shubhammishra0212/nazar-hardware/diagrams/NAZAR-Circuit-Diagrams-Cirkit.pdf

# NAZAR v5 - Circuit Diagrams

ESP32 DevKit (38-pin) - 24 V adapter, two LM2596 bucks (belt motor on 5.5 V, LEDs on 12 V), belt relay - 2 Nov 2026

NAZAR v5 - Team Parakh - INDUX 5.0 | 1 / 7

### Power

From | To | Notes
24 V adapter + | LM2596 #1 IN+ and LM2596 #2 IN+ | adapter 2 A or more
24 V adapter - | LM2596 #1 IN- and LM2596 #2 IN- | common ground
LM2596 #1 OUT+ | ESP32 5V, MG996R red, C1 +, relay DC+, S1 | set to 5.5 V
S1 COM | INA219 VIN+ | belt ON / OFF switch
INA219 VIN- | Relay NO | INA219 measures motor current
Relay COM | Belt motor + | belt runs only while the relay is on
LM2596 #1 OUT- | ESP32 GND, MG996R brown, C1, relay DC-, motor -
LM2596 #2 OUT+ | LED strip +12V | set to 12 V, LEDs only
LM2596 #2 OUT- | LED strip GND

### ESP32 pin map

ESP32 pin | Goes to | Notes
GPIO21 (SDA) | INA219, MPU-6050, BH1750 SDA | blue
GPIO22 (SCL) | INA219, MPU-6050, BH1750 SCL | green
3.3 V | I2C modules, FC-51, DS18B20, 4.7 kΩ | red
GPIO18 | FC-51 OUT | purple
GPIO4 | DS18B20 DQ + 4.7 kΩ to 3.3 V | yellow
GPIO13 | 330 Ω -> MG996R signal | cyan
GPIO26 | Relay IN (HIGH = belt runs, LOW = stops) | indigo
5V | LM2596 #1 OUT+ (5.5 V) | orange
GND | all grounds joined | black

### Before you power it

### 1. Connect only the 24 V adapter. Turn each buck's brass screw and read the

output with a multimeter: LM2596 #1 = 5.5 V, LM2596 #2 = 12 V.

### 2. Mark the bucks "5V" and "12V" with tape. 12 V on the ESP32 side

destroys the ESP32 and the servo.

3. Fit C1 (1000 µF 16 V) across the 5.5 V rail: + to 5.5 V, stripe to GND.

### 4. Use thick wire (about 20 AWG) for both power rails. LM2596 #1 now feeds

the ESP32, servo, relay AND belt motor - stick a heatsink on it.
The belt runs at about half speed on 5.5 V (that is expected).

### 5. If the ESP32 resets when the servo moves, add another 470-1000 µF

capacitor right at the ESP32 5V and GND pins.

### 6. Check the ESP32 has its USB diode before plugging USB in while the

5.5 V rail is live, or unplug the 5V wire while uploading code.

### 7. Relay: our BC547 board is active HIGH (GPIO26 HIGH = belt runs). The belt

only runs while the ESP32 is on and holds the relay; it stops under the camera for each washer. A 1N4007 across the motor (stripe to +) is a plus.

### I2C addresses

I2C device | Address | Strap
INA219 | 0x40 | default
MPU-6050 | 0x68 | AD0 -> GND
BH1750 | 0x23 | ADDR -> GND

# Complete wiring

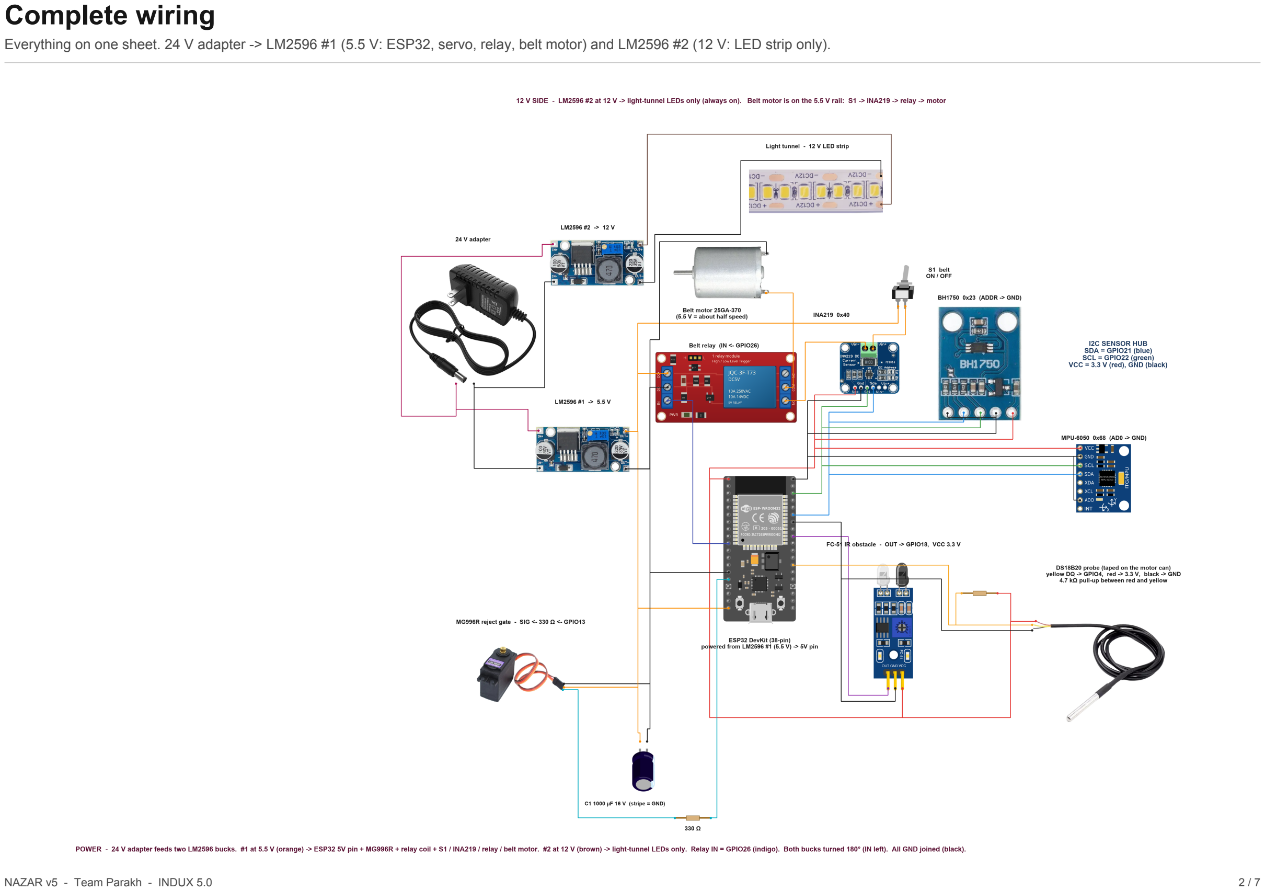
[picture p4: page 2]

Everything on one sheet. 24 V adapter -> LM2596 #1 (5.5 V: ESP32, servo, relay, belt motor) and LM2596 #2 (12 V: LED strip only).

# Part 1 - Power, light tunnel, belt motor and relay

LM2596 #1 (5.5 V): ESP32 5V pin, MG996R, C1, relay coil, and S1 -> INA219 -> relay -> belt motor. LM2596 #2 (12 V): LED strip only (always on). Relay IN = GPIO26.

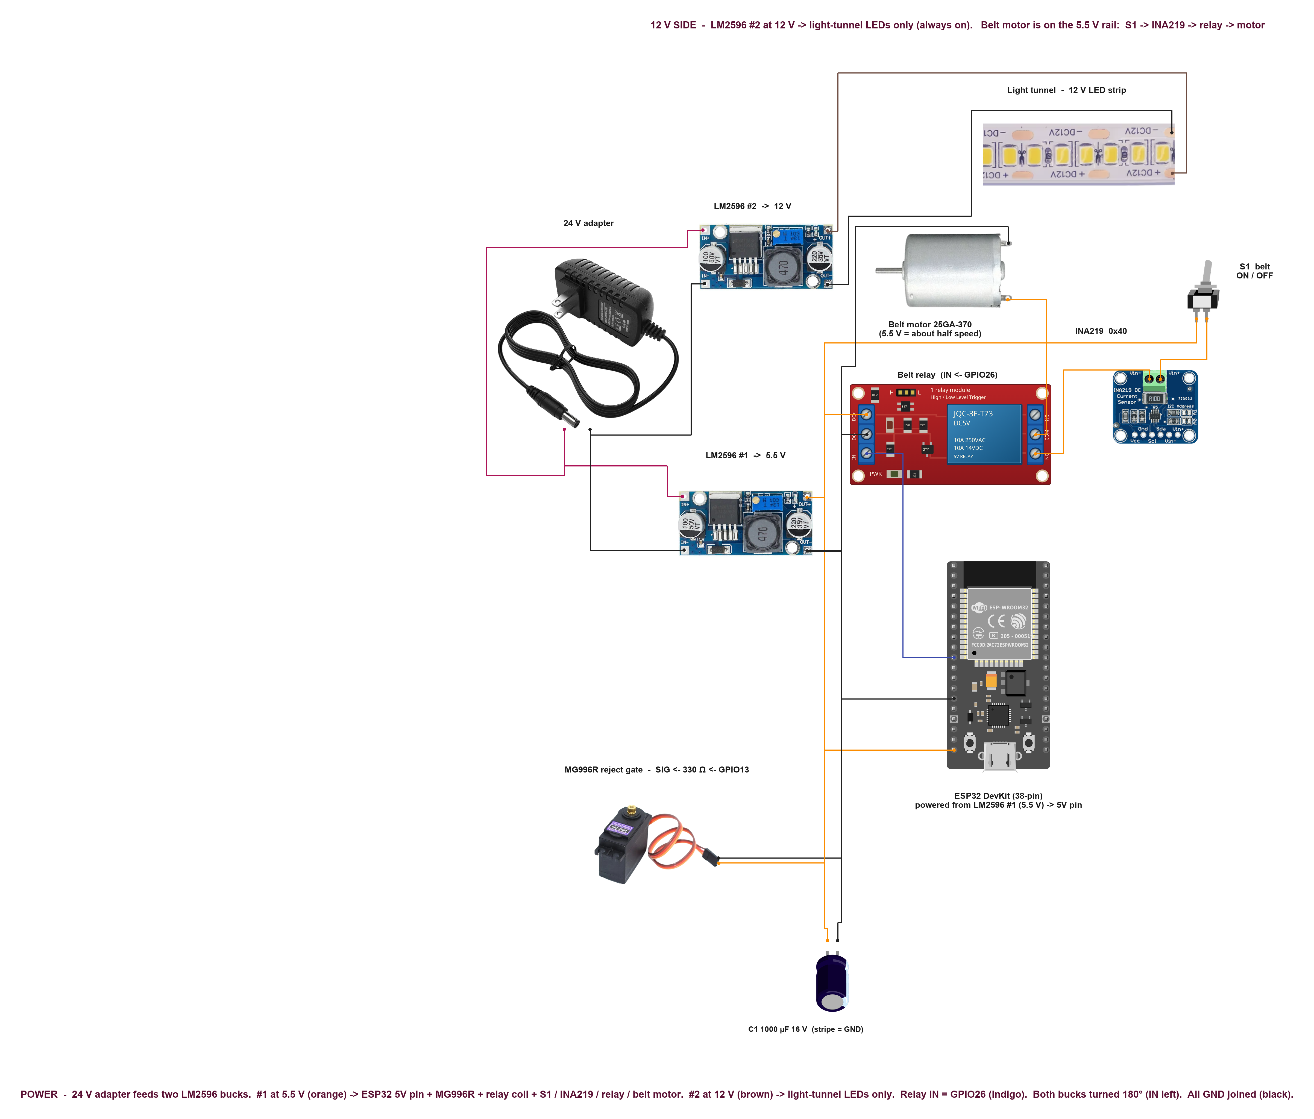
[picture p5: figure]

# Part 2 - I2C sensor hub

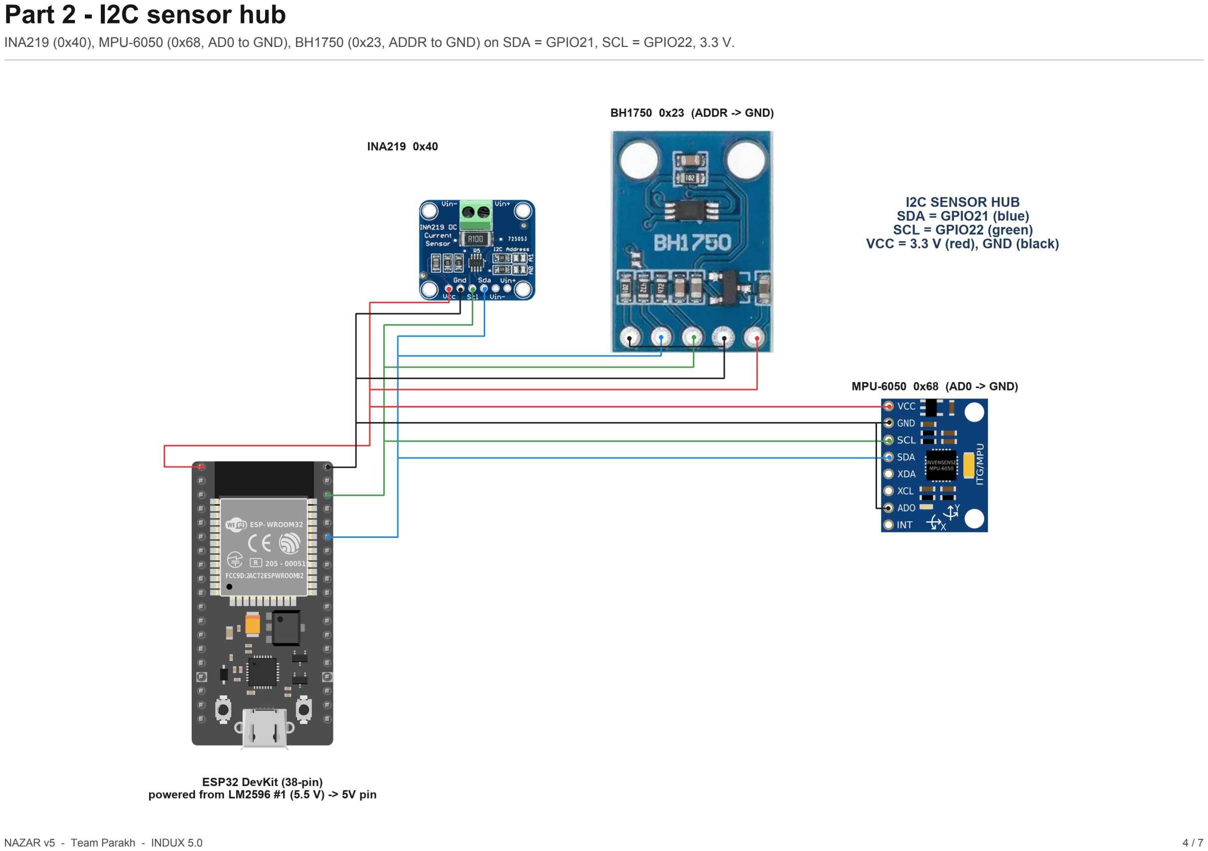
[picture p6: page 4]

INA219 (0x40), MPU-6050 (0x68, AD0 to GND), BH1750 (0x23, ADDR to GND) on SDA = GPIO21, SCL = GPIO22, 3.3 V.

# Part 3 - FC-51 IR obstacle sensor

OUT -> GPIO18. Runs on 3.3 V so the output is safe for the ESP32.

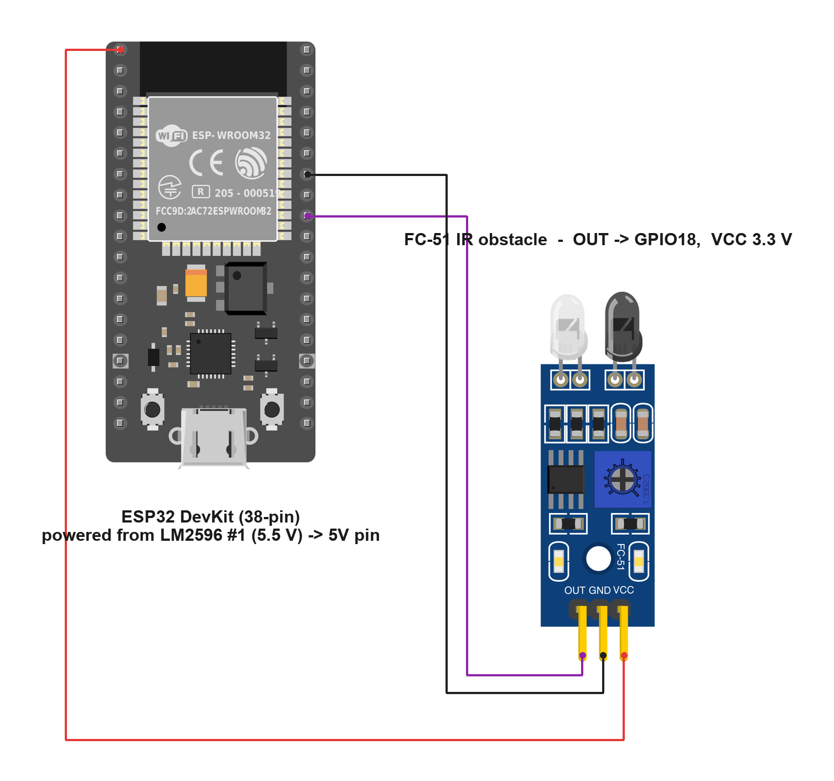
[picture p7: figure]

# Part 4 - DS18B20 motor temperature

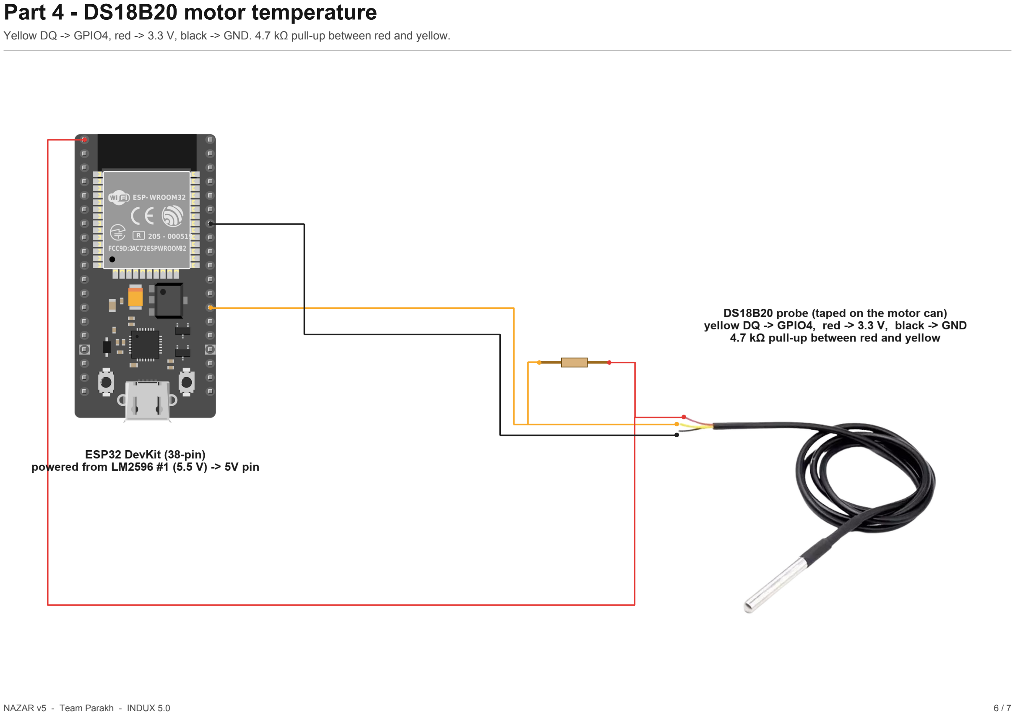
[picture p8: page 6]

Yellow DQ -> GPIO4, red -> 3.3 V, black -> GND. 4.7 kΩ pull-up between red and yellow.

# Part 5 - Reject gate servo

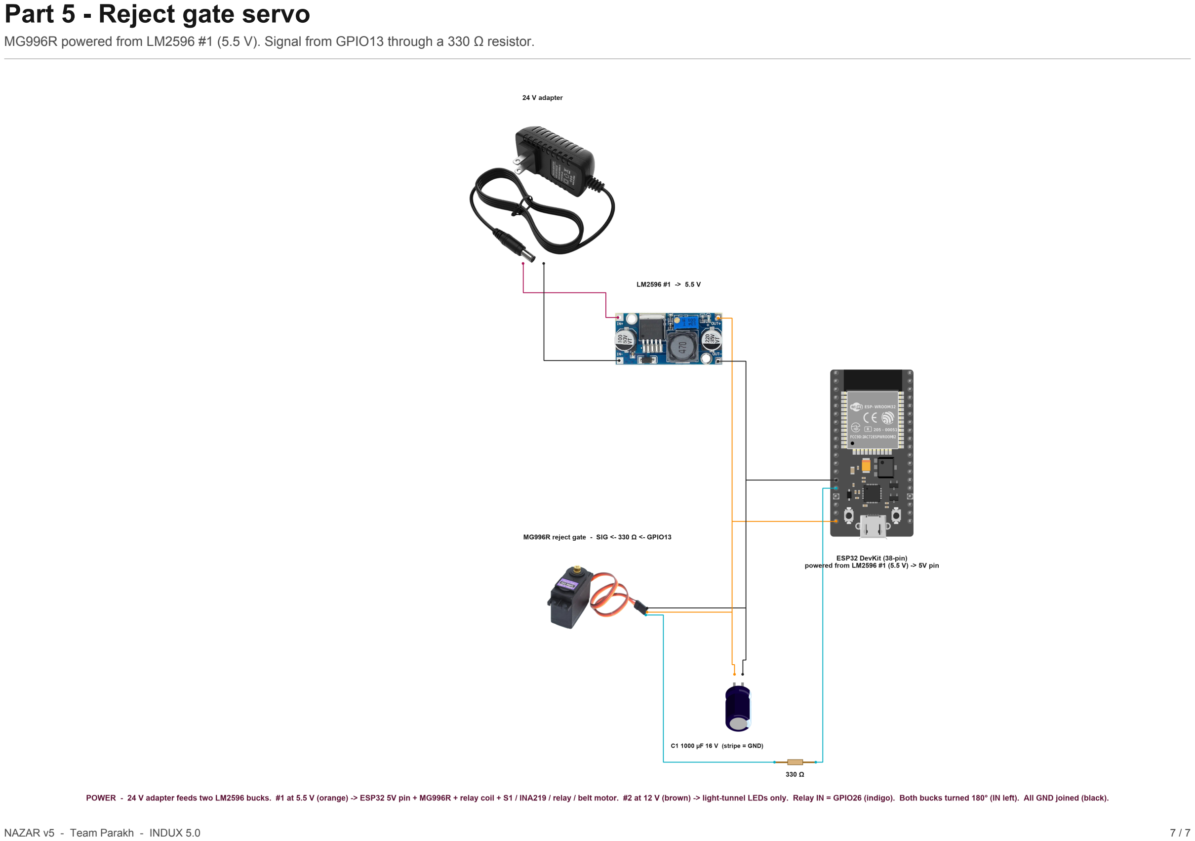
[picture p9: page 7]

MG996R powered from LM2596 #1 (5.5 V). Signal from GPIO13 through a 330 Ω resistor.
