shubhammishra0212/nazar-hardware/diagrams/NAZAR-2-I2C-Sensors.png

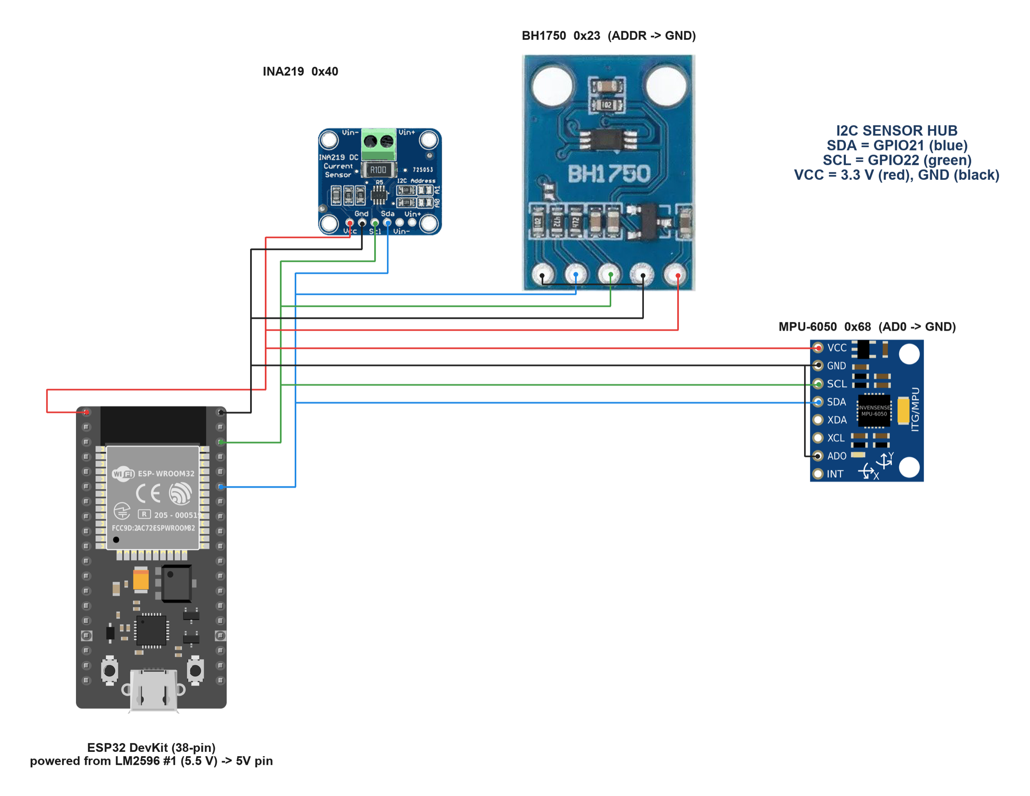
diagrams/NAZAR-2-I2C-Sensors.png
