shubhammishra0212/nazar-hardware/diagrams/NAZAR-4-DS18B20.png

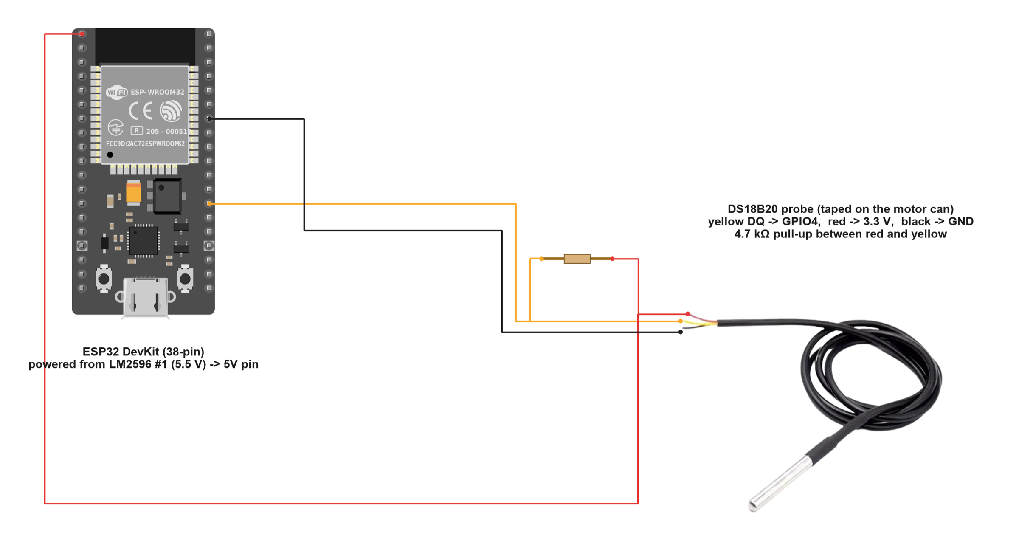
diagrams/NAZAR-4-DS18B20.png
