shubhammishra0212/nazar-hardware/diagrams/NAZAR-5-Reject-Gate.png

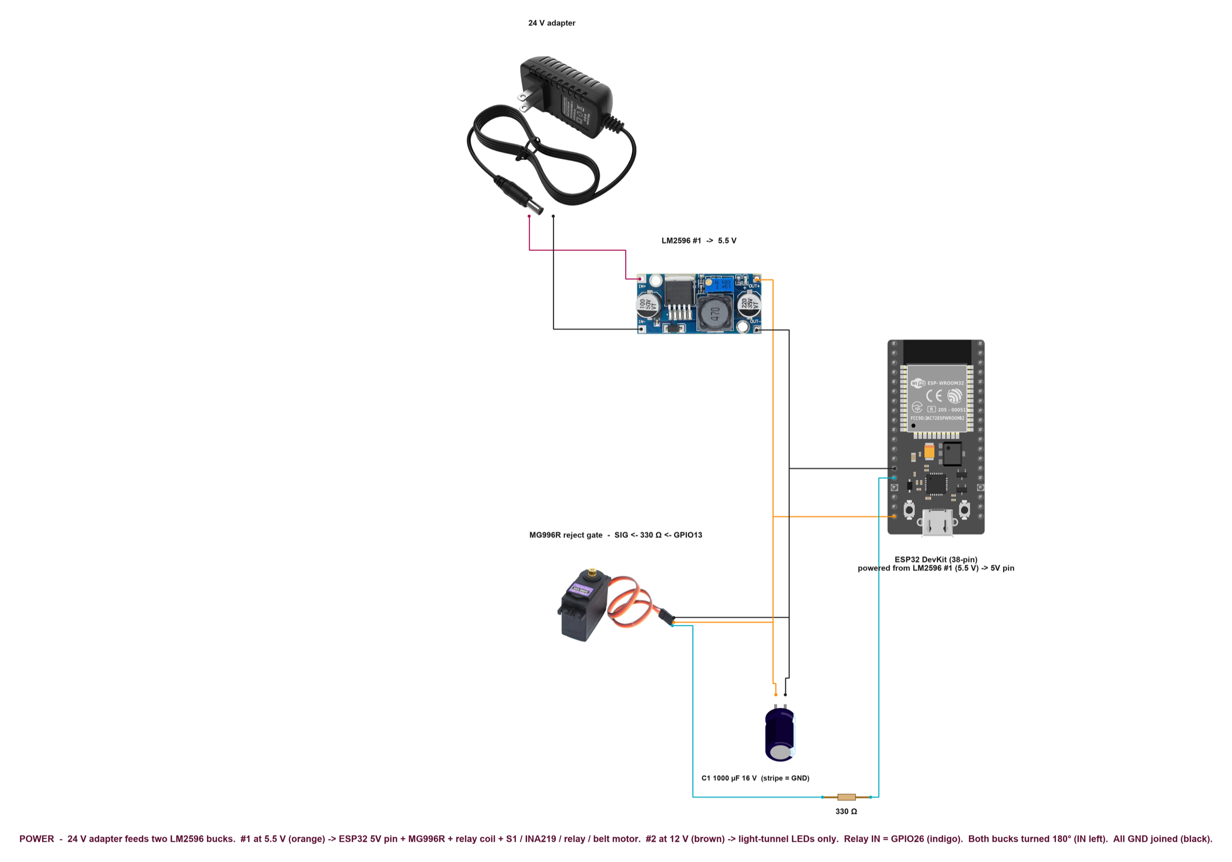
diagrams/NAZAR-5-Reject-Gate.png
