shubhammishra0212/nazar-hardware/mechanical/stl/PLATE_ALL_BRACKETS_preview.png

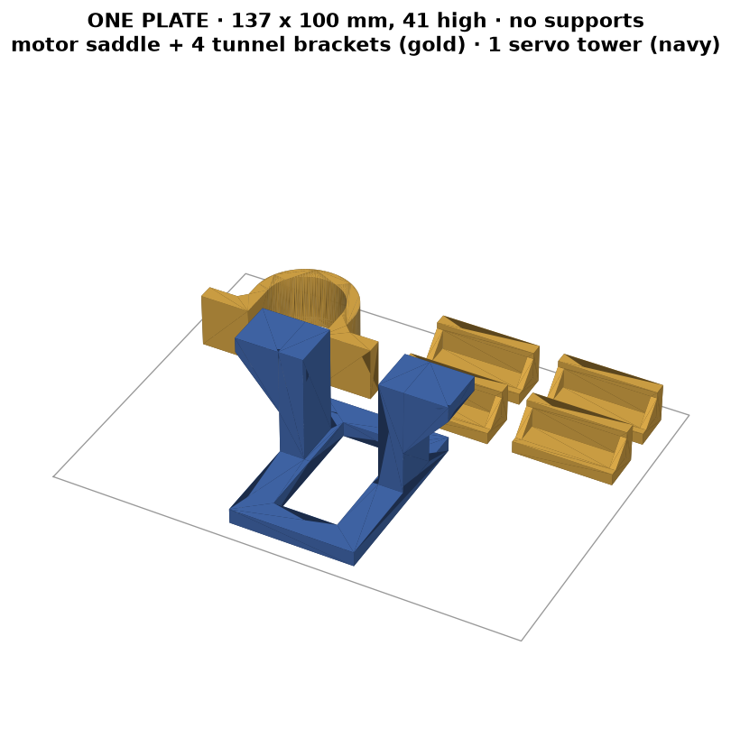
mechanical/stl/PLATE_ALL_BRACKETS_preview.png
