shubhammishra0212/nazar-hardware/mechanical/stl/P13_SERVO_TOWER_MG996R_BLANK.stl

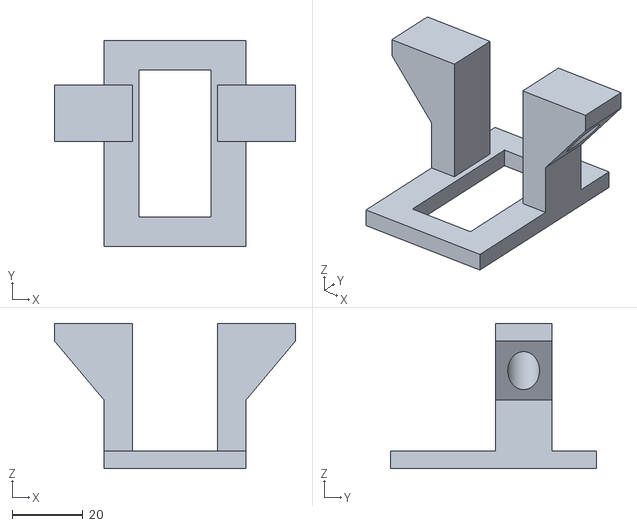
[picture p14: CAD file, 2026-11-02]
mechanical/stl/P13_SERVO_TOWER_MG996R_BLANK.stl
68.0 x 58.0 x 41.0
