shubhammishra0212/nazar-hardware/mechanical/stl/PLATE_P16_GEARS_C33_0_pinion18T+roller36T.stl

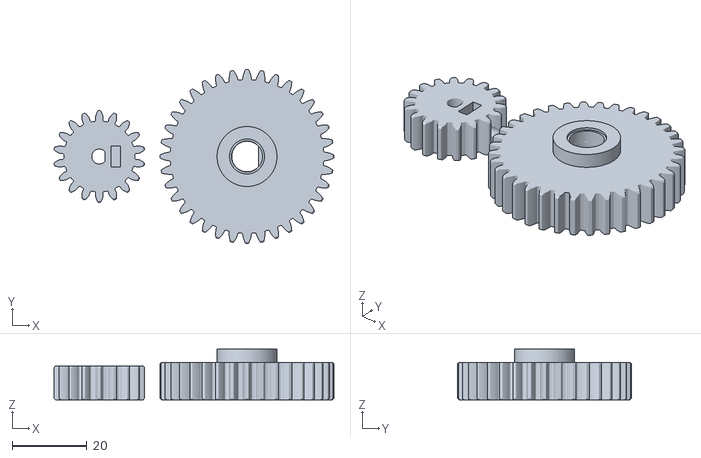
[picture p15: CAD file, 2026-11-02]
mechanical/stl/PLATE_P16_GEARS_C33_0_pinion18T+roller36T.stl
74.8 x 46.4 x 13.5
