shubhammishra0212/nazar-hardware/mechanical/stl/P7S_MOTOR_SADDLE_25GA.stl

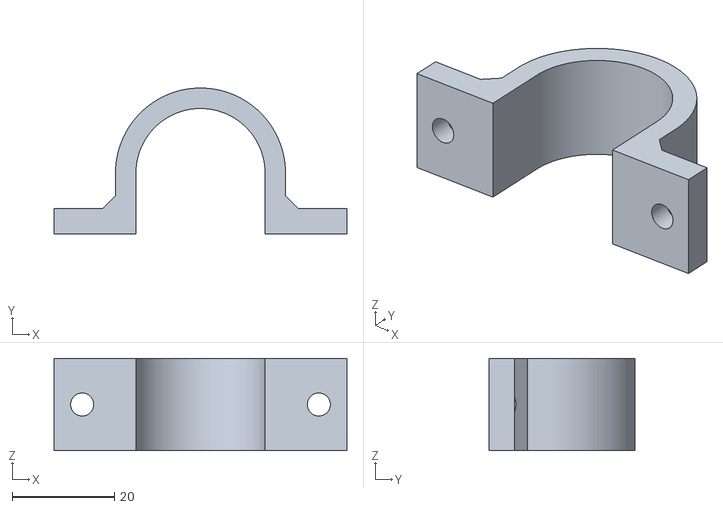
[picture p16: CAD file, 2026-11-02]
mechanical/stl/P7S_MOTOR_SADDLE_25GA.stl
57.2 x 28.5 x 18.0
