shubhammishra0212/nazar-hardware/mechanical/stl/PLATE_ALL_BRACKETS_saddle+tunnel_x4+servo_x1.stl

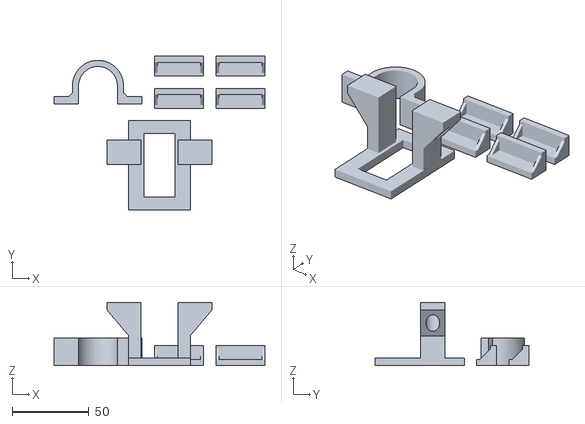
[picture p17: CAD file, 2026-11-02]
mechanical/stl/PLATE_ALL_BRACKETS_saddle+tunnel_x4+servo_x1.stl
137.2 x 100.0 x 41.0
