shubhammishra0212/nazar-hardware/mechanical/stl/PLATE_P14_SORT_ARM_REJECT_hub+blade.stl

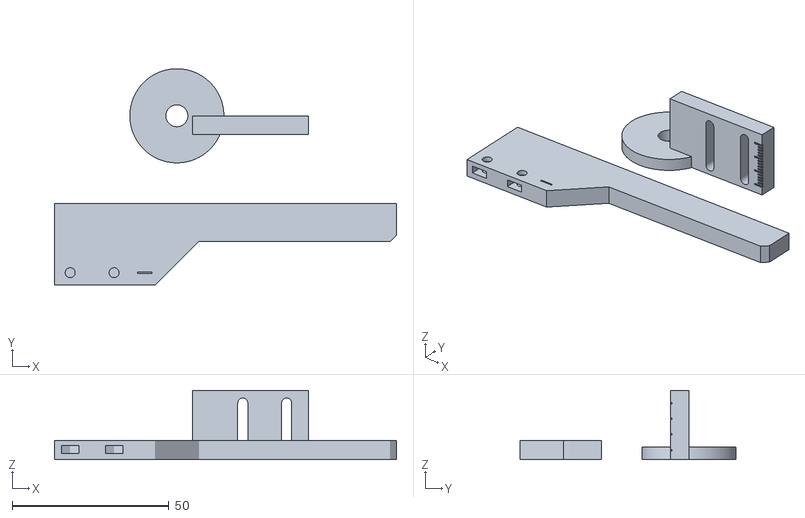
[picture p18: CAD file, 2026-11-02]
mechanical/stl/PLATE_P14_SORT_ARM_REJECT_hub+blade.stl
109.0 x 69.0 x 22.0
