shubhammishra0212/nazar-hardware/(commit log)

2026-11-02 Add wiring diagrams, Cirkit files and printed parts
    [P13_SERVO_TOWER_MG996R_BLANK.stl, P7S_MOTOR_SADDLE_25GA.stl, PLATE_ALL_BRACKETS_saddle+tunnel_x4+servo_x1.stl, PLATE_P14_SORT_ARM_REJECT_hub+blade.stl, PLATE_P16_GEARS_C33_0_pinion18T+roller36T.stl]
2026-11-02 Belt motor on the 5.5 V buck; 12 V buck feeds the LED strip only
    Rewired S1 -> INA219 -> relay -> motor to LM2596 #1 in all diagrams,
    Cirkit files and the A3 PDF. Bring-up guide and README updated to match.
2026-11-02 Relay docs: our BC547 board is active HIGH; how to find NO/COM/NC
2026-11-03 Hardware doc: servo arm is a stop gate since fw 2.2
